FGalvagno/acopladores/README.md

# Acopladores
Este repositorio contiene archivos e información relevante a la realización del primer trabajo práctico de la materia Electrónica Analógica III en Ing. Electronica FCEFyN-UNC.

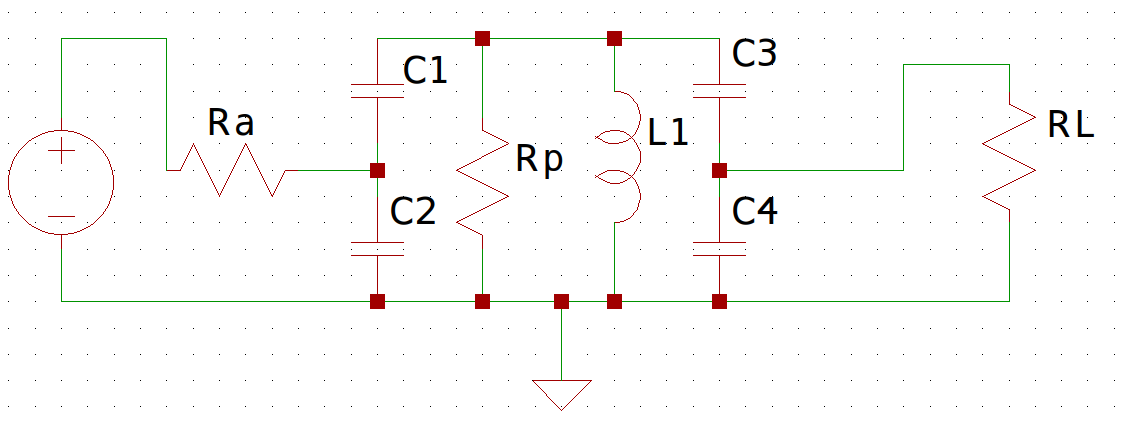
[picture p1: informe/fig/circuito.png]
Circuito


## Diseño de Placa
Los archivos coupler contienen el negativo utilizado para fabricar el PCB a modo prototipo con plancha.

## Simulación
El archivo editable_coupler.asc contiene la simulación interactiva del acoplador diseñado en el TP. A su vez el archivo tabla.ipynb es un notebook de jupyter que posee todos los calculos relacionados con el diseño del inductor y la selección de los capacitores.
