FGalvagno/acopladores/informe/titlepage.tex

\begin{titlepage}

\begin{center}
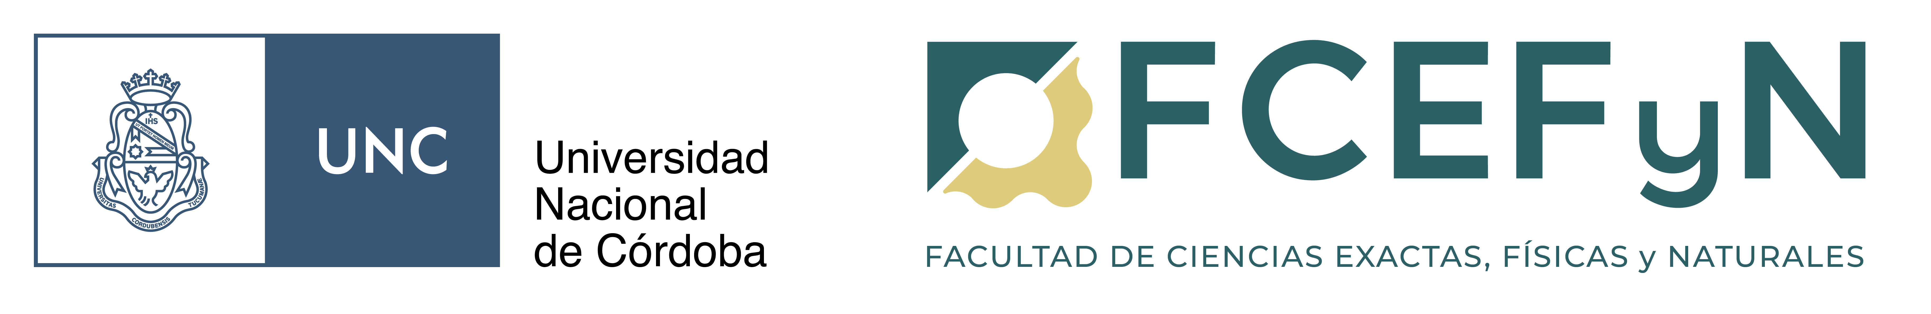
[picture p21: informe/fig/color_UNC-FCEFyN.png]
     
    \\[1cm]
    \vspace{5pt}
    \ \LARGE Universidad Nacional de Córdoba\\[0.5cm] 
    \large Facultad de Ciencias Exactas, Físicas y Naturales \\[0.5cm] 
    \large Electrónica Analógica III
    \\[0.2cm]
    \large TP N° 1
    \\[0.2cm]
    \large Acopladores
    \\[0.2cm]
    \vspace{360pt}
    \begin{table}[!h]
    \centering
    \begin{tabular}{ll}
    \multicolumn{1}{c}{Nombre} & \multicolumn{1}{c}{DNI} \\
    Galvagno Facundo Nahuel& 40815088 \\
    
    \end{tabular}
    \end{table}
\vfill Córdoba, República Argentina\\ \today
\end{center}

\end{titlepage}
