FGalvagno/acopladores/informe/main.tex

\documentclass{article}
\usepackage[utf8]{inputenc}
\usepackage{graphicx}
\usepackage[spanish,es-tabla]{babel}
\usepackage{amsmath}
\usepackage[a4paper,margin=1in,footskip=.5cm]{geometry}
\usepackage{subcaption}
\setlength\headheight{30pt} 
\usepackage{fancyhdr}
\usepackage{amssymb}
\usepackage[hidelinks]{hyperref}
\usepackage{mathtools}
\usepackage[table,xcdraw]{xcolor}
\usepackage[backend=bibtex]{biblatex}
\usepackage{csquotes}
\usepackage{float}
\usepackage{listings}
\usepackage{xcolor}
\usepackage{circuitikz}

\definecolor{codegreen}{rgb}{0,0.6,0}
\definecolor{codegray}{rgb}{0.5,0.5,0.5}
\definecolor{codepurple}{rgb}{0.58,0,0.82}
\definecolor{backcolour}{rgb}{0.95,0.95,0.92}

\lstdefinestyle{mystyle}{
    backgroundcolor=\color{white},   
    commentstyle=\color{codegreen},
    keywordstyle=\color{magenta},
    numberstyle=\tiny\color{codegray},
    stringstyle=\color{codepurple},
    basicstyle=\ttfamily\small,
    breakatwhitespace=false,         
    breaklines=true,                 
    captionpos=b,                    
    keepspaces=true,
    numbersep=5pt,                  
    showspaces=false,                
    showstringspaces=false,
    showtabs=false,                  
    tabsize=2
}

\lstset{style=mystyle}

\hypersetup{
colorlinks = true,
urlcolor=blue,
linkcolor = black
}
\title{TP1_EAIII}
\author{FACUNDO NAHUEL GALVAGNO}
\date{April 2025}

\begin{document}

\renewcommand{\figureautorefname}{Fig.}
\renewcommand{\tableautorefname}{Tab.}
\renewcommand{\equationautorefname}{Ec.}

\pagestyle{fancy}
\fancyhf{}
\fancyhead[R]{}
\fancyhead[L]{Electrónica Analógica III - Acopladores}
\fancyfoot[R]{\thepage}
\renewcommand{\headrulewidth}{0.1pt}
% agregamos la caratula
\input{titlepage}
\newpage

\tableofcontents
\newpage

\input{introduccion}
\newpage

\input{diseño}
\newpage

\input{simulacion}
\newpage

\input{implementacion}
\newpage

\input{conclusiones}
\newpage

\input{pi}
\newpage
\end{document}
