FGalvagno/acopladores/coupler.pdf

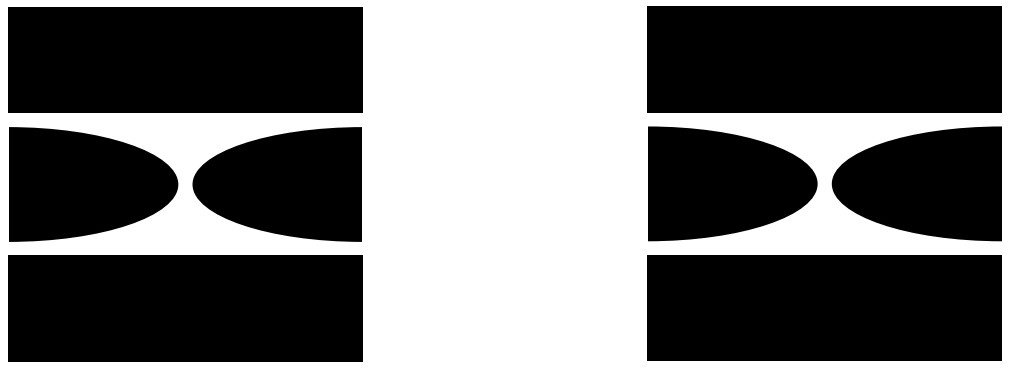
[picture p23: figure]
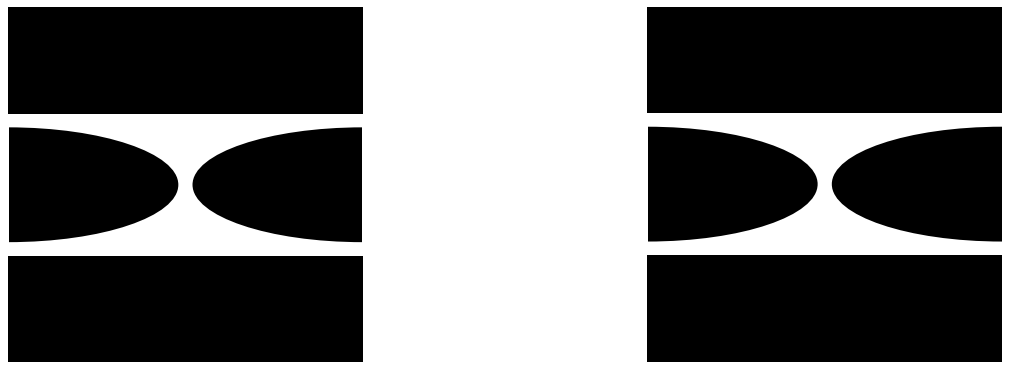
[picture p24: figure]
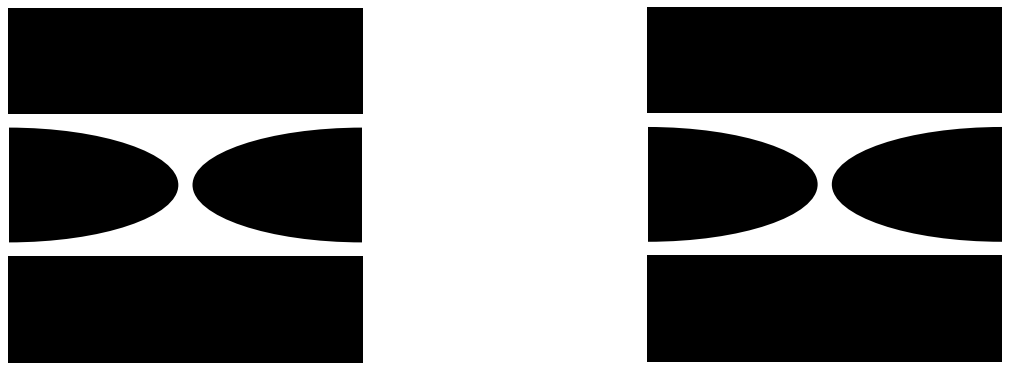
[picture p25: figure]
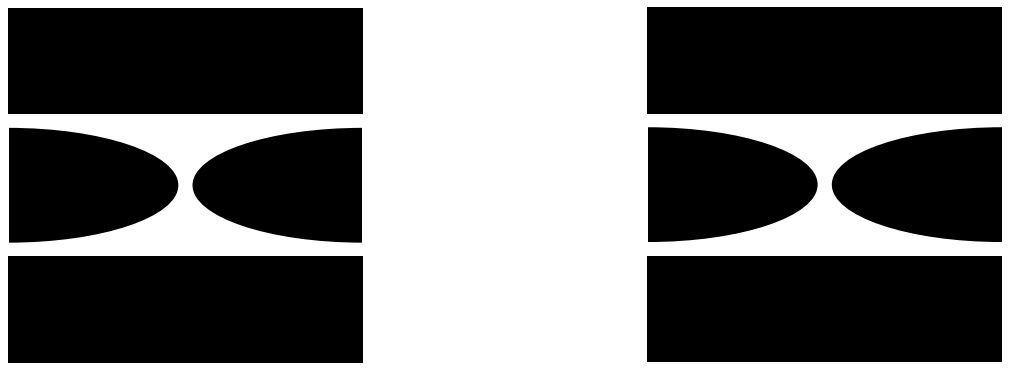
[picture p26: figure]
