FGalvagno/acopladores/informe/oscilo/SDS00002.jpg

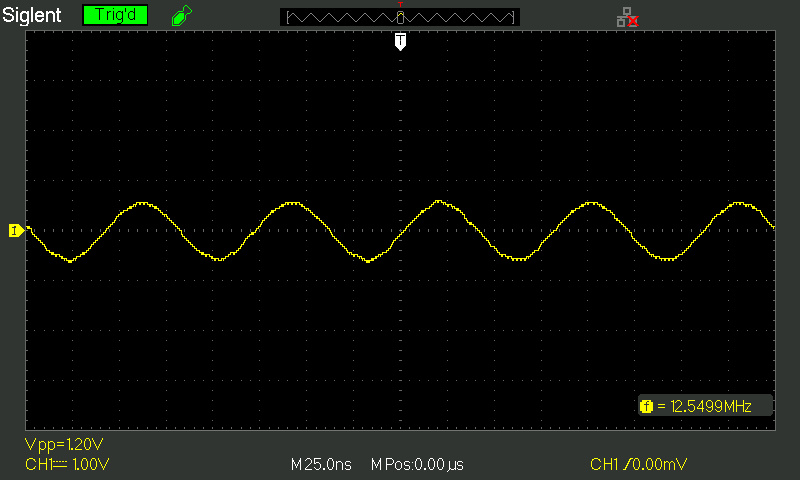
informe/oscilo/SDS00002.jpg
