FGalvagno/acopladores/informe/oscilo/SDS00005.jpg

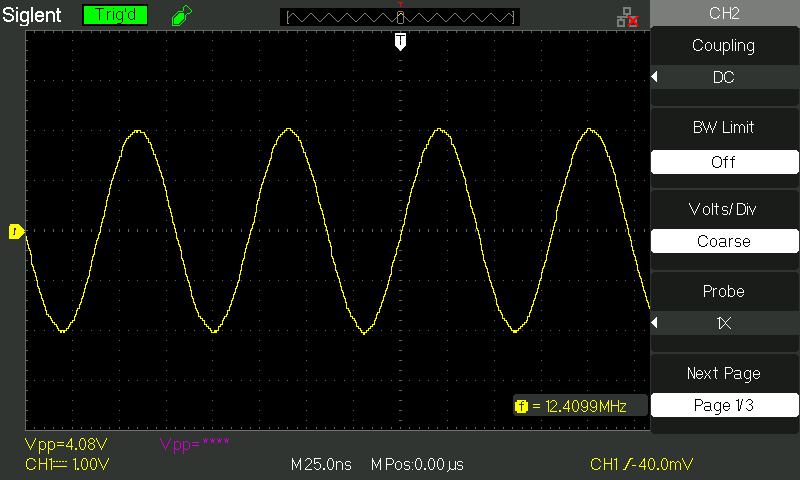
informe/oscilo/SDS00005.jpg
