FGalvagno/acopladores/informe/oscilo/SDS00009.jpg

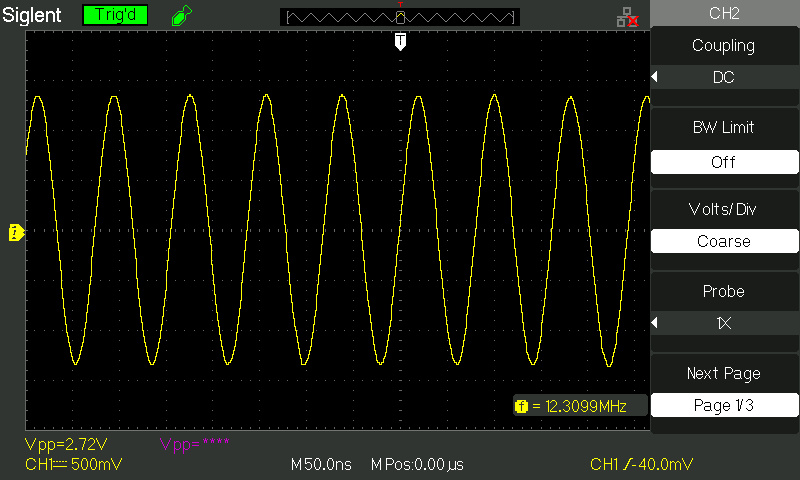
informe/oscilo/SDS00009.jpg
