FGalvagno/acopladores/informe/oscilo/SDS00012.jpg

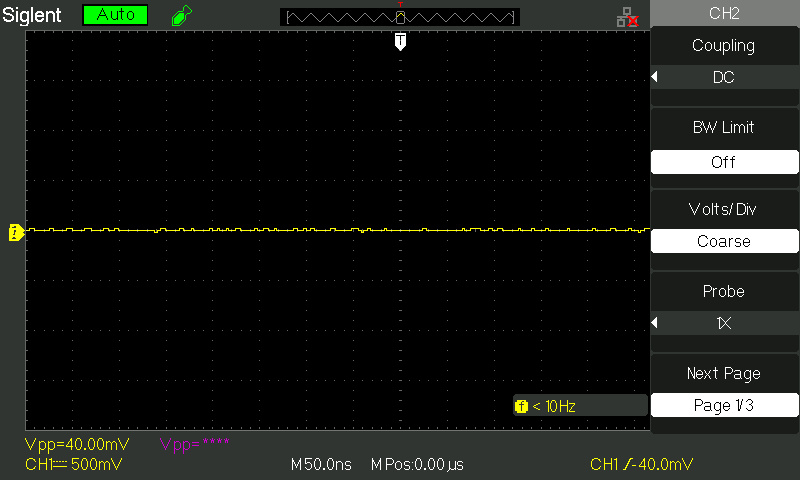
informe/oscilo/SDS00012.jpg
