FGalvagno/acopladores/informe/oscilo/SDS00013.jpg

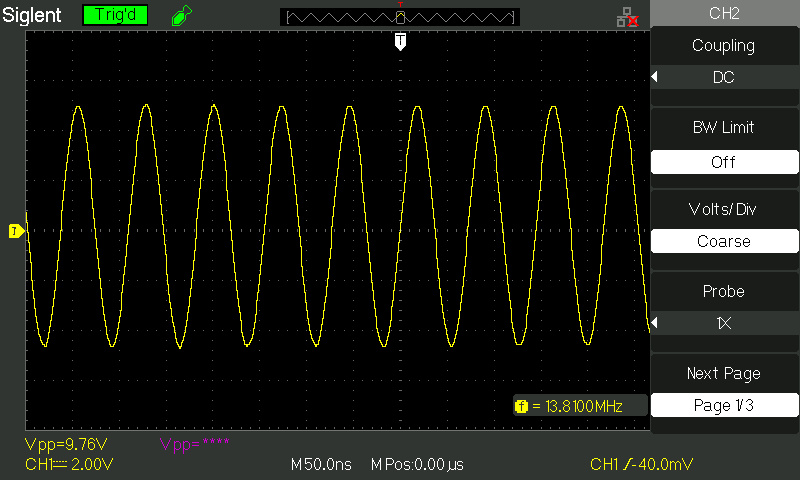
informe/oscilo/SDS00013.jpg
