FGalvagno/acopladores/informe/oscilo/SDS00014.jpg

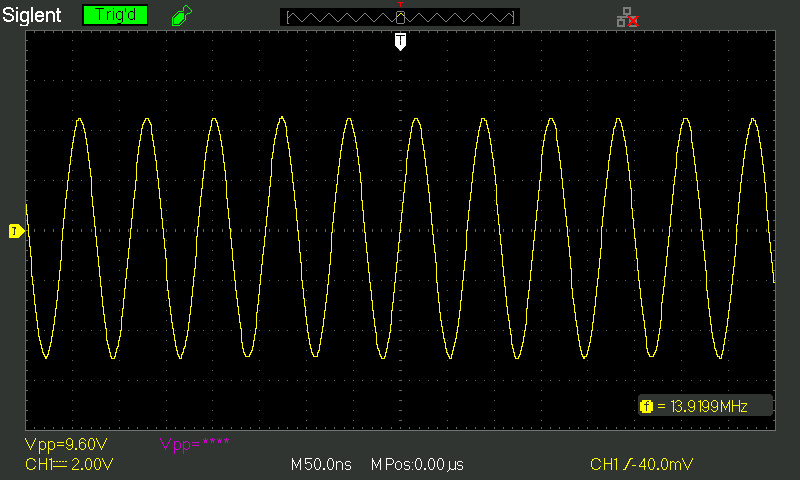
informe/oscilo/SDS00014.jpg
