FGalvagno/acopladores/informe/oscilo/SDS00020.jpg

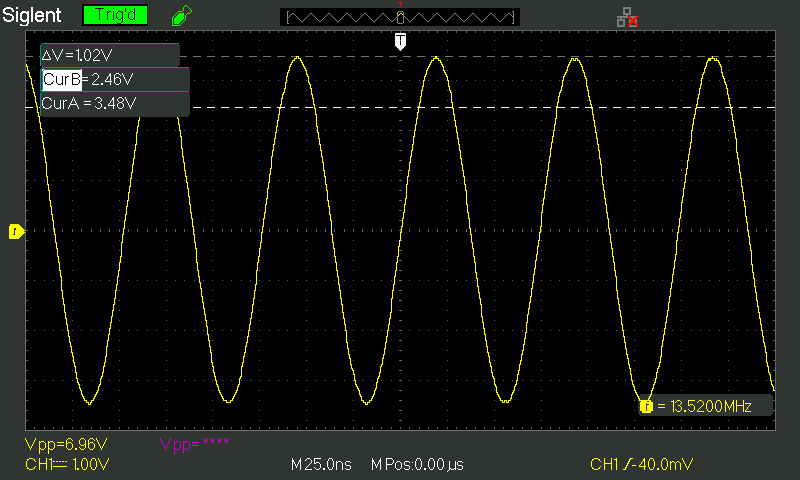
informe/oscilo/SDS00020.jpg
