FGalvagno/acopladores/editable_coupler.asc

C1: cap; 94.451p
C2: cap; 364.183p
C3: cap; 752.132p
C4: cap; 83.307p
CF: cap
L1: ind; 521n
Ra: res; 50
Rp: res; 1Meg
RT: res; 22K
V1: voltage; SINE(0 1 18M); AC 3
Named nets: 0
.ac dec 1000 10000000 28000000
.param C1_val=100p C2_val=330p C3_val=680p C4_val=82p
.param L1_val=521n
.param Rp_val=26.51k RL_val=1k Rg=50
Coupler with f = 1/(2*pi*sqrt(L*C))
(C1*C2)/(C1+C2) = C/2
(C3*C4)/(C3+C4) = C/2
